thomotron/keyboard/TestKeypad/TestKeypad.kicad_pcb

## KiCad design TestKeypad/TestKeypad.kicad_pcb (2021-01-30)

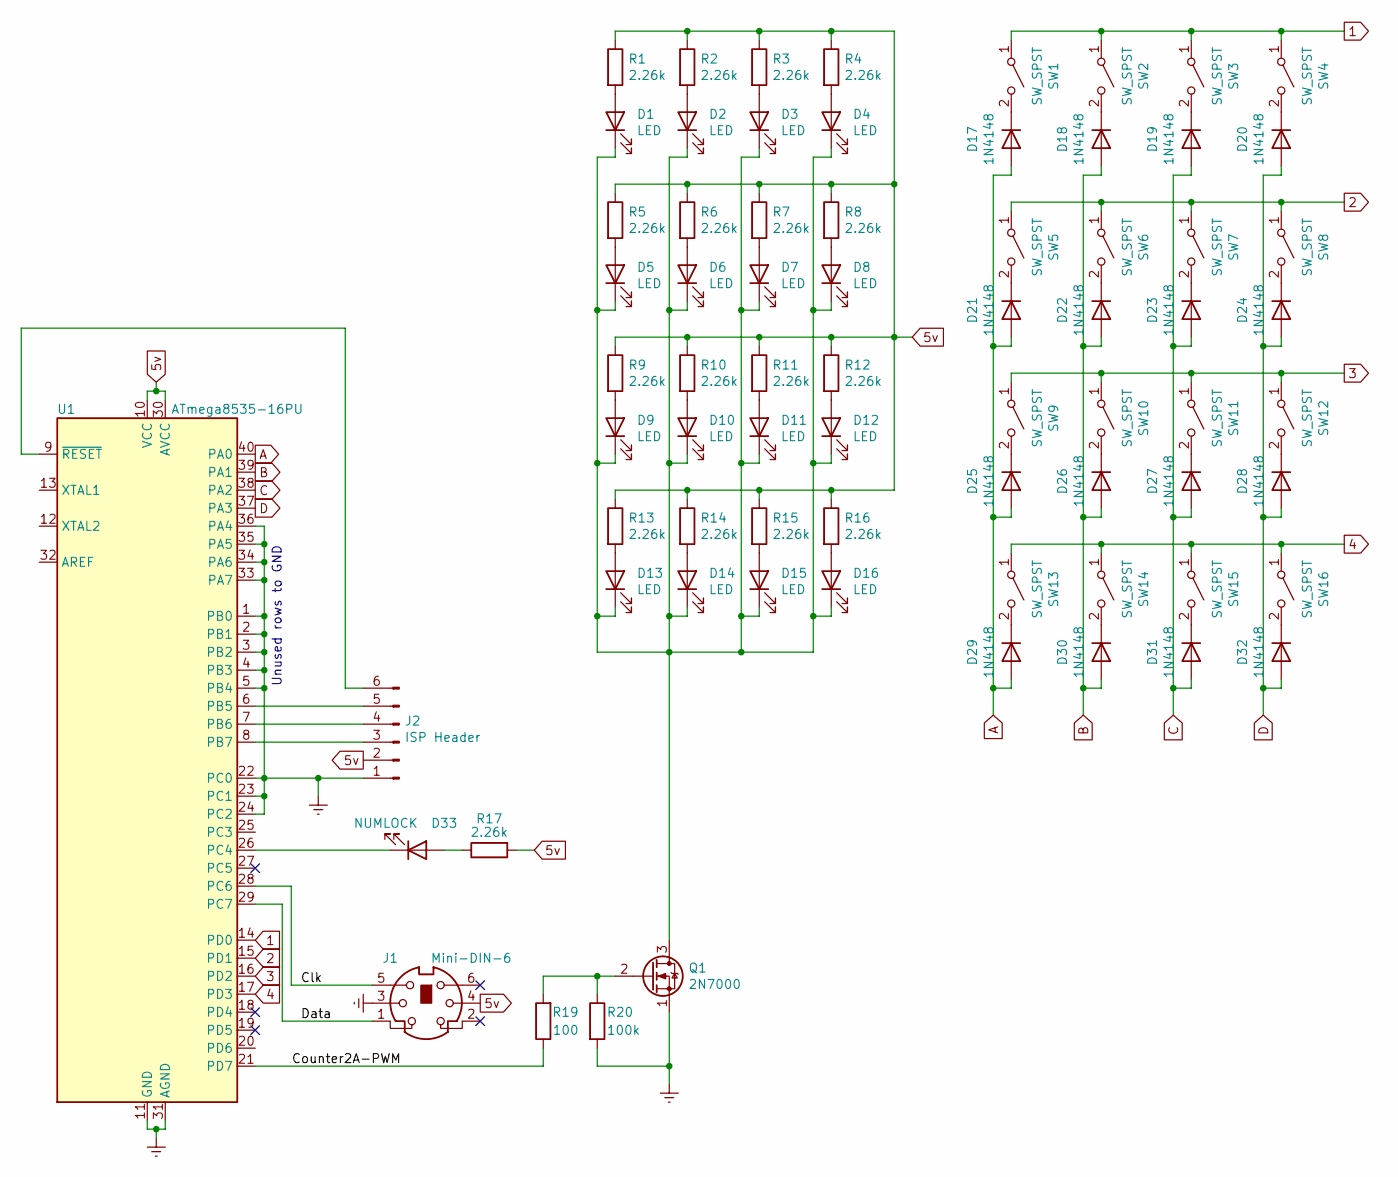
[picture p1: schematic TestKeypad.sch]

Parts:
D1, D2, D3, D4, D5, D6, D7, D8, D9, D10, D11, D12, D13, D14, D15, D16: LED; 158301250
D17, D18, D19, D20, D21, D22, D23, D24, D25, D26, D27, D28, D29, D30, D31, D32: 1N4148; D_MiniMELF
D33: NUMLOCK; 158301250
J1: Mini-DIN-6; Connector_Mini-DIN_Female_6Pin_2rows
J2: ISP Header; PinHeader_2x03_P2.54mm_Vertical
Q1: 2N7000; TO-92_Inline
R1, R2, R3, R4, R5, R6, R7, R8, R9, R10, R11, R12, R13, R14, R15, R16, R17: 2.26k; R_0805_2012Metric_Pad1.15x1.40mm_HandSolder
R19: 100; R_0805_2012Metric_Pad1.15x1.40mm_HandSolder
R20: 100k; R_0805_2012Metric_Pad1.15x1.40mm_HandSolder
SW1, SW2, SW3, SW4, SW5, SW6, SW7, SW8, SW9, SW10, SW11, SW12, SW13, SW14, SW15, SW16: SW_SPST; SW_Cherry_MX_1.00u_PCB
U1: ATmega8535-16PU; DIP-40_W15.24mm_Socket

Connections:
1: SW1.1 (A), SW2.1 (A), SW3.1 (A), SW4.1 (A), U1.14 (PD0)
2: SW5.1 (A), SW6.1 (A), SW7.1 (A), SW8.1 (A), U1.15 (PD1)
3: SW9.1 (A), SW10.1 (A), SW11.1 (A), SW12.1 (A), U1.16 (PD2)
4: SW13.1 (A), SW14.1 (A), SW15.1 (A), SW16.1 (A), U1.17 (PD3)
5v: J1.4, J2.2, R1.1, R2.1, R3.1, R4.1, R5.1, R6.1, R7.1, R8.1, R9.1, R10.1, R11.1, R12.1, R13.1, R14.1, R15.1, R16.1, R17.2, U1.10 (VCC), U1.30 (AVCC)
/Clk: J1.5, U1.28 (PC6)
/Counter2A-PWM: R19.1, U1.21 (PD7)
/Data: J1.1, U1.29 (PC7)
A: D17.2 (A), D21.2 (A), D25.2 (A), D29.2 (A), U1.40 (PA0)
B: D18.2 (A), D22.2 (A), D26.2 (A), D30.2 (A), U1.39 (PA1)
C: D19.2 (A), D23.2 (A), D27.2 (A), D31.2 (A), U1.38 (PA2)
D: D20.2 (A), D24.2 (A), D28.2 (A), D32.2 (A), U1.37 (PA3)
Earth: J1.3, J2.1, Q1.1 (S), R20.2, U1.1 (PB0), U1.2 (PB1), U1.3 (PB2), U1.4 (PB3), U1.5 (PB4), U1.11 (GND), U1.22 (PC0), U1.23 (PC1), U1.24 (PC2), U1.31 (AGND), U1.33 (PA7), U1.34 (PA6), U1.35 (PA5), U1.36 (PA4)
unnamed: D1.1 (K), D2.1 (K), D3.1 (K), D4.1 (K), D5.1 (K), D6.1 (K), D7.1 (K), D8.1 (K), D9.1 (K), D10.1 (K), D11.1 (K), D12.1 (K), D13.1 (K), D14.1 (K), D15.1 (K), D16.1 (K), Q1.3 (D)
unnamed: D1.2 (A), R1.2
unnamed: D2.2 (A), R2.2
unnamed: D3.2 (A), R3.2
unnamed: D4.2 (A), R4.2
unnamed: D5.2 (A), R5.2
unnamed: D6.2 (A), R6.2
unnamed: D7.2 (A), R7.2
unnamed: D8.2 (A), R8.2
unnamed: D9.2 (A), R9.2
unnamed: D10.2 (A), R10.2
unnamed: D11.2 (A), R11.2
unnamed: D12.2 (A), R12.2
unnamed: D13.2 (A), R13.2
unnamed: D14.2 (A), R14.2
unnamed: D15.2 (A), R15.2
unnamed: D16.2 (A), R16.2
unnamed: D17.1 (K), SW1.2 (B)
unnamed: D18.1 (K), SW2.2 (B)
unnamed: D19.1 (K), SW3.2 (B)
unnamed: D20.1 (K), SW4.2 (B)
unnamed: D21.1 (K), SW5.2 (B)
unnamed: D22.1 (K), SW6.2 (B)
unnamed: D23.1 (K), SW7.2 (B)
unnamed: D24.1 (K), SW8.2 (B)
unnamed: D25.1 (K), SW9.2 (B)
unnamed: D26.1 (K), SW10.2 (B)
unnamed: D27.1 (K), SW11.2 (B)
unnamed: D28.1 (K), SW12.2 (B)
unnamed: D29.1 (K), SW13.2 (B)
unnamed: D30.1 (K), SW14.2 (B)
unnamed: D31.1 (K), SW15.2 (B)
unnamed: D32.1 (K), SW16.2 (B)
unnamed: D33.1 (K), U1.26 (PC4)
unnamed: D33.2 (A), R17.1
unnamed: J2.3, U1.8 (PB7)
unnamed: J2.4, U1.7 (PB6)
unnamed: J2.5, U1.6 (PB5)
unnamed: J2.6, U1.9 (~RESET)
unnamed: Q1.2 (G), R19.2, R20.1

Notes on the sheet:
Unused rows to GND

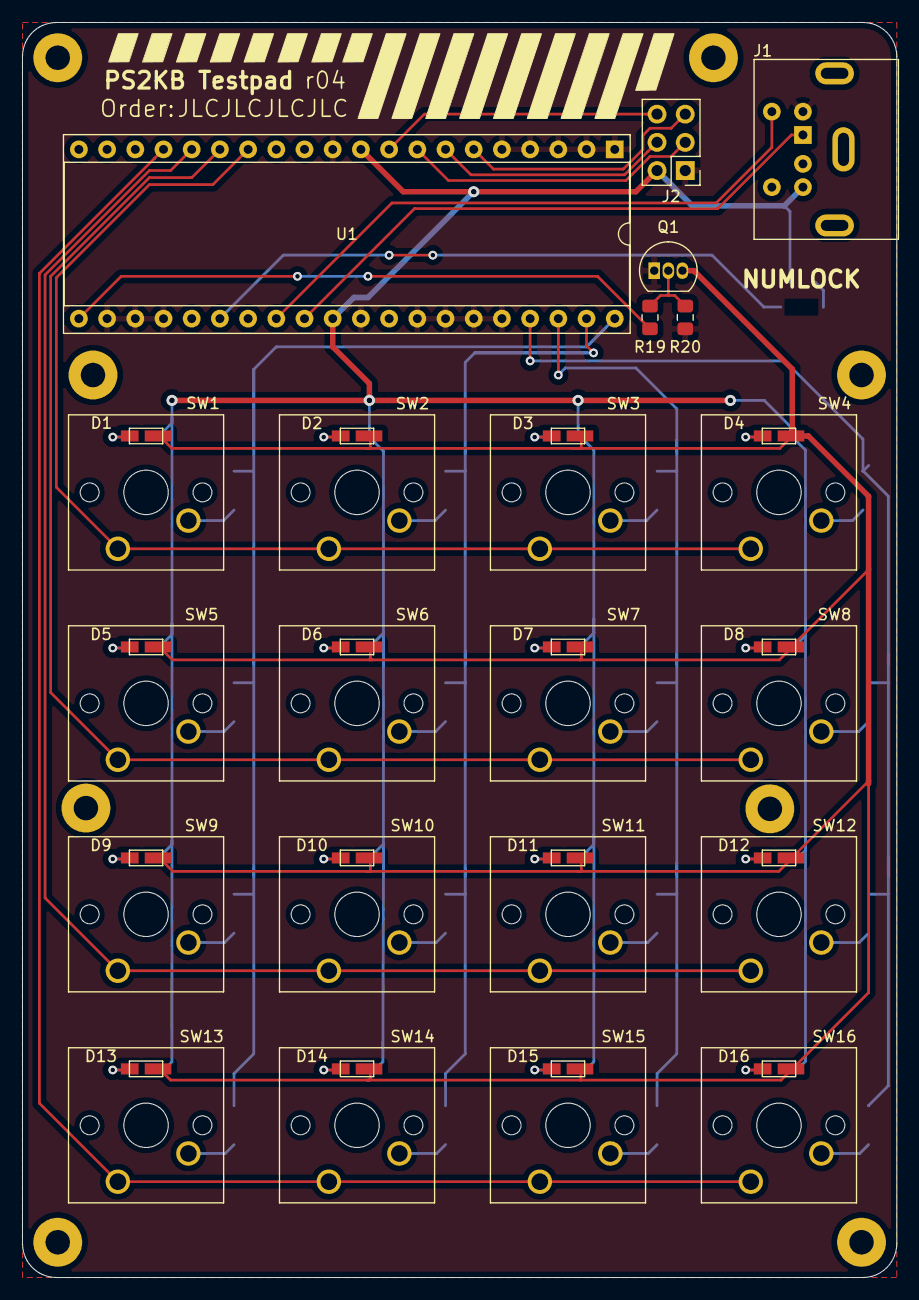
[picture p2: board TestKeypad.kicad_pcb from above]

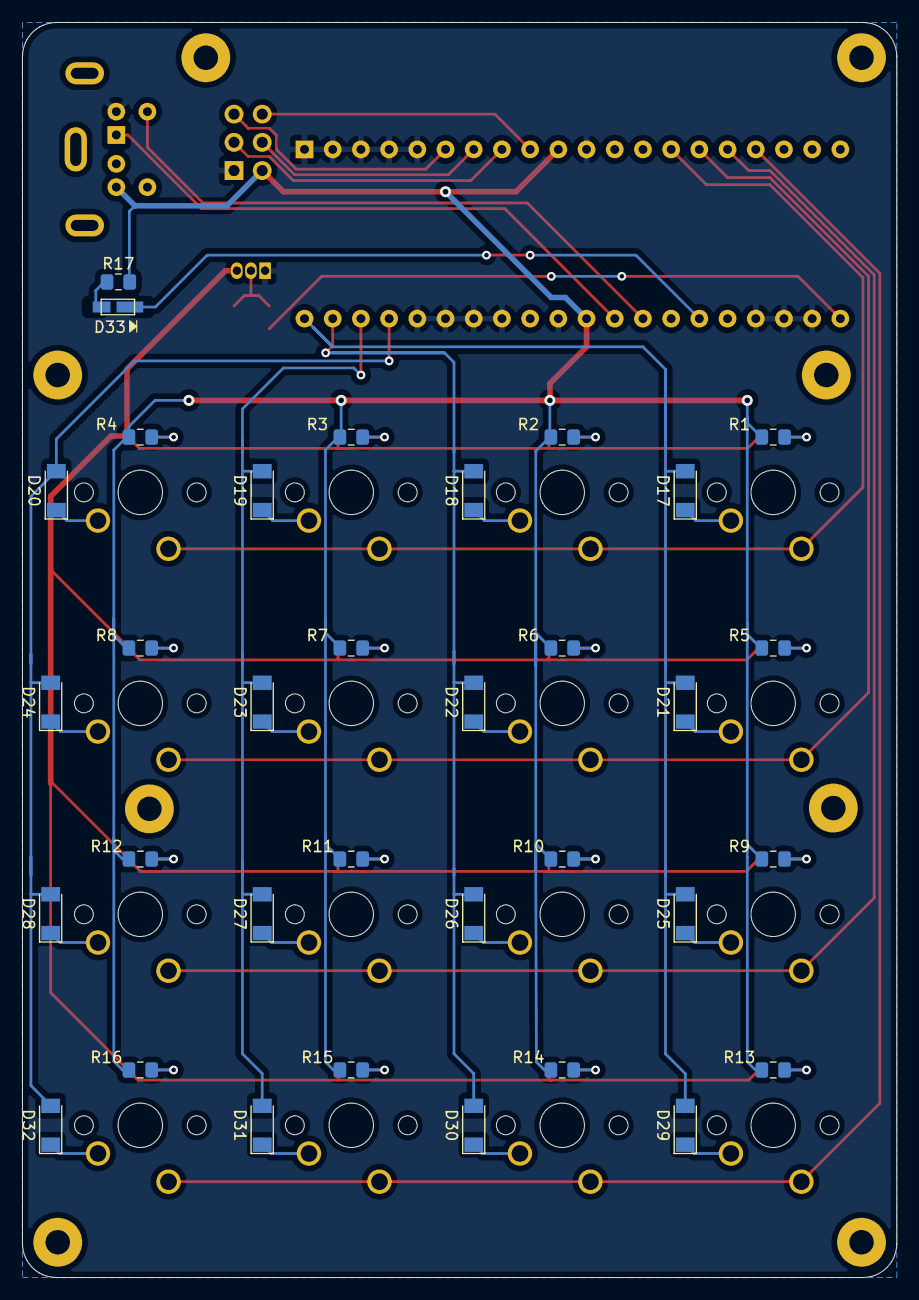
[picture p3: board TestKeypad.kicad_pcb from below]

Board: 2 copper layers, 78.7 x 113.0 mm, 72 parts (34 on the bottom side), 53 nets.
