thomotron/keyboard/Keyboard/MyOwnKeyboard.kicad_pcb

## KiCad design Keyboard/MyOwnKeyboard.kicad_pcb (2020-12-05)

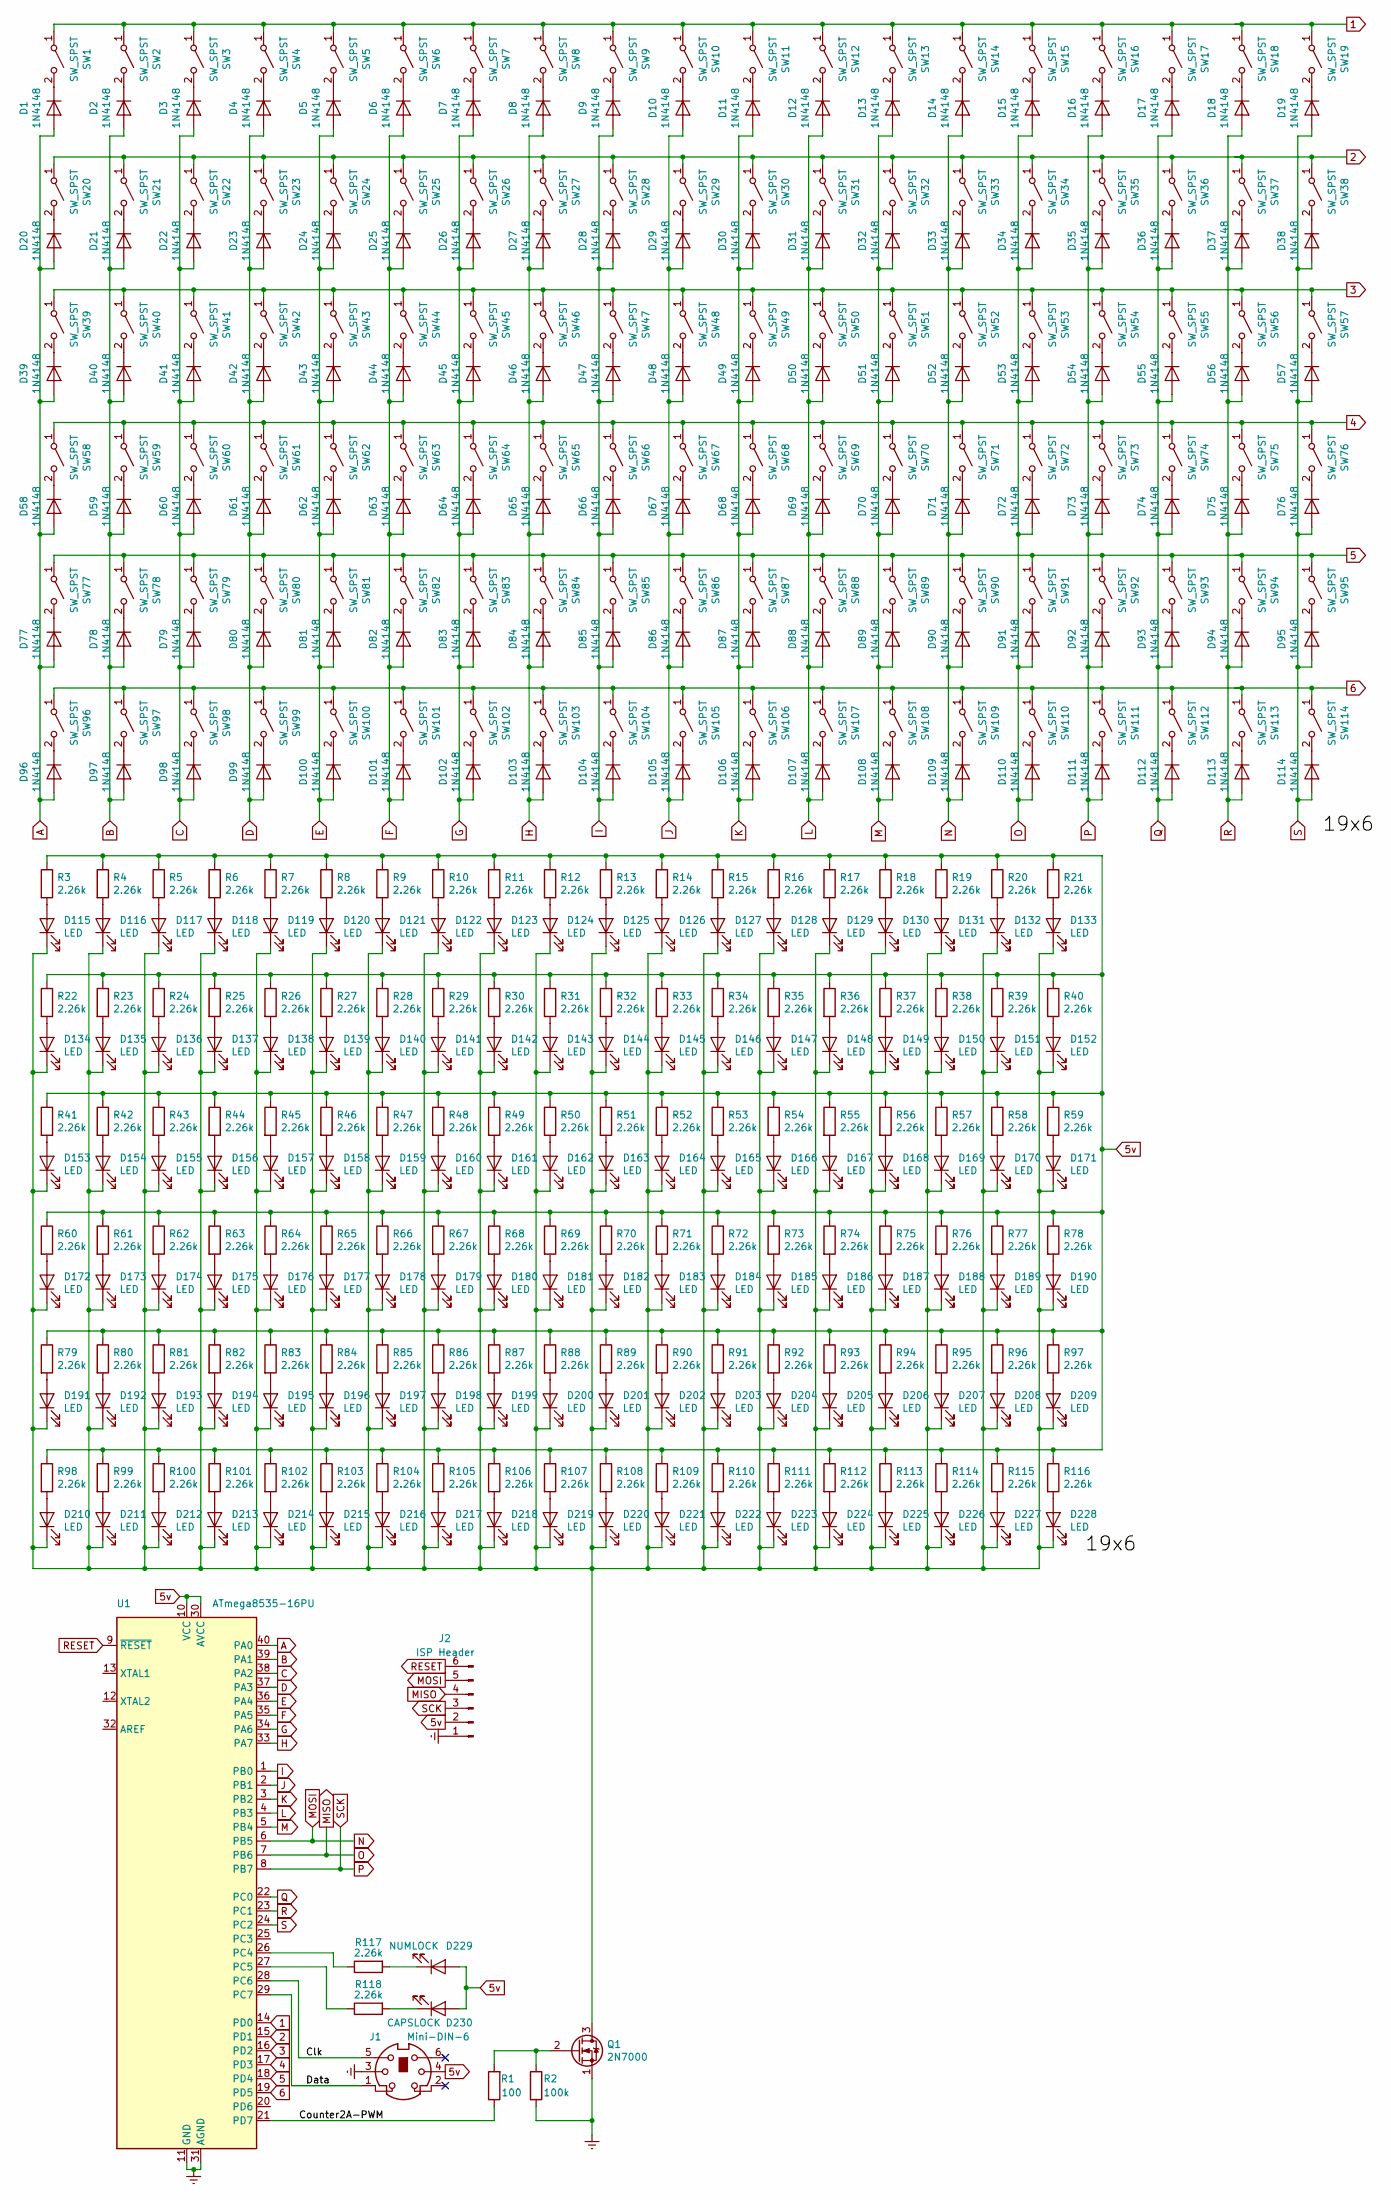
[picture p4: schematic MyOwnKeyboard.sch]

Parts:
D1, D2, D3, D4, D5, D6, D7, D8, D9, D10, D11, D12, D13, D14, D15, D16, D17, D18, D19, D20, D21, D22, D23, D24, D25, D26, D27, D28, D29, D30, D31, D32, D33, D34, D35, D36, D37, D38, D39, D40, D41, D42, D43, D44, D45, D46, D47, D48, D49, D50, D51, D52, D53, D54, D55, D56, D57, D58, D59, D60, D61, D62, D63, D64, D65, D66, D67, D68, D69, D70, D71, D72, D73, D74, D75, D76, D77, D78, D79, D80, D81, D82, D83, D84, D85, D86, D87, D88, D89, D90, D91, D92, D93, D94, D95, D96, D97, D98, D99, D100, D101, D102, D103, D104, D105, D106, D107, D108, D109, D110, D111, D112, D113, D114: 1N4148; D_MiniMELF
D115, D116, D117, D118, D119, D120, D121, D122, D123, D124, D125, D126, D127, D128, D129, D130, D131, D132, D133, D134, D135, D136, D137, D138, D139, D140, D141, D142, D143, D144, D145, D146, D147, D148, D149, D150, D151, D152, D153, D154, D155, D156, D157, D158, D159, D160, D161, D162, D163, D164, D165, D166, D167, D168, D169, D170, D171, D172, D173, D174, D175, D176, D177, D178, D179, D180, D181, D182, D183, D184, D185, D186, D187, D188, D189, D190, D191, D192, D193, D194, D195, D196, D197, D198, D199, D200, D201, D202, D203, D204, D205, D206, D207, D208, D209, D210, D211, D212, D213, D214, D215, D216, D217, D218, D219, D220, D221, D222, D223, D224, D225, D226, D227, D228: LED; 158301250
D229: NUMLOCK; 158301250
D230: CAPSLOCK; 158301250
J1: Mini-DIN-6; Connector_Mini-DIN_Female_6Pin_2rows
J2: ISP Header; PinHeader_2x03_P2.54mm_Vertical
Q1: 2N7000; TO-92_Inline
R1: 100; R_0805_2012Metric_Pad1.15x1.40mm_HandSolder
R2: 100k; R_0805_2012Metric_Pad1.15x1.40mm_HandSolder
R3, R4, R5, R6, R7, R8, R9, R10, R11, R12, R13, R14, R15, R16, R17, R18, R19, R20, R21, R22, R23, R24, R25, R26, R27, R28, R29, R30, R31, R32, R33, R34, R35, R36, R37, R38, R39, R40, R41, R42, R43, R44, R45, R46, R47, R48, R49, R50, R51, R52, R53, R54, R55, R56, R57, R58, R59, R60, R61, R62, R63, R64, R65, R66, R67, R68, R69, R70, R71, R72, R73, R74, R75, R76, R77, R78, R79, R80, R81, R82, R83, R84, R85, R86, R87, R88, R89, R90, R91, R92, R93, R94, R95, R96, R97, R98, R99, R100, R101, R102, R103, R104, R105, R106, R107, R108, R109, R110, R111, R112, R113, R114, R115, R116, R117, R118: 2.26k; R_0805_2012Metric_Pad1.15x1.40mm_HandSolder
SW1, SW2, SW3, SW4, SW5, SW6, SW7, SW8, SW9, SW10, SW11, SW12, SW13, SW14, SW15, SW16, SW17, SW18, SW19, SW20, SW21, SW22, SW23, SW24, SW25, SW26, SW27, SW28, SW29, SW30, SW31, SW32, SW33, SW34, SW35, SW36, SW37, SW38, SW39, SW40, SW41, SW42, SW43, SW44, SW45, SW46, SW47, SW48, SW49, SW50, SW51, SW52, SW53, SW54, SW55, SW56, SW57, SW58, SW59, SW60, SW61, SW62, SW63, SW64, SW65, SW66, SW67, SW68, SW69, SW70, SW71, SW72, SW73, SW74, SW75, SW76, SW77, SW78, SW79, SW80, SW81, SW82, SW83, SW84, SW85, SW86, SW87, SW88, SW89, SW90, SW91, SW92, SW93, SW94, SW95, SW96, SW97, SW98, SW99, SW100, SW101, SW102, SW103, SW104, SW105, SW106, SW107, SW108, SW109, SW110, SW111, SW112, SW113, SW114: SW_SPST; SW_Cherry_MX_1.00u_PCB
U1: ATmega8535-16PU; DIP-40_W15.24mm

Connections:
1: SW1.1 (A), SW2.1 (A), SW3.1 (A), SW4.1 (A), SW5.1 (A), SW6.1 (A), SW7.1 (A), SW8.1 (A), SW9.1 (A), SW10.1 (A), SW11.1 (A), SW12.1 (A), SW13.1 (A), SW14.1 (A), SW15.1 (A), SW16.1 (A), SW17.1 (A), SW18.1 (A), SW19.1 (A), U1.14 (PD0)
2: SW20.1 (A), SW21.1 (A), SW22.1 (A), SW23.1 (A), SW24.1 (A), SW25.1 (A), SW26.1 (A), SW27.1 (A), SW28.1 (A), SW29.1 (A), SW30.1 (A), SW31.1 (A), SW32.1 (A), SW33.1 (A), SW34.1 (A), SW35.1 (A), SW36.1 (A), SW37.1 (A), SW38.1 (A), U1.15 (PD1)
3: SW39.1 (A), SW40.1 (A), SW41.1 (A), SW42.1 (A), SW43.1 (A), SW44.1 (A), SW45.1 (A), SW46.1 (A), SW47.1 (A), SW48.1 (A), SW49.1 (A), SW50.1 (A), SW51.1 (A), SW52.1 (A), SW53.1 (A), SW54.1 (A), SW55.1 (A), SW56.1 (A), SW57.1 (A), U1.16 (PD2)
4: SW58.1 (A), SW59.1 (A), SW60.1 (A), SW61.1 (A), SW62.1 (A), SW63.1 (A), SW64.1 (A), SW65.1 (A), SW66.1 (A), SW67.1 (A), SW68.1 (A), SW69.1 (A), SW70.1 (A), SW71.1 (A), SW72.1 (A), SW73.1 (A), SW74.1 (A), SW75.1 (A), SW76.1 (A), U1.17 (PD3)
5: SW77.1 (A), SW78.1 (A), SW79.1 (A), SW80.1 (A), SW81.1 (A), SW82.1 (A), SW83.1 (A), SW84.1 (A), SW85.1 (A), SW86.1 (A), SW87.1 (A), SW88.1 (A), SW89.1 (A), SW90.1 (A), SW91.1 (A), SW92.1 (A), SW93.1 (A), SW94.1 (A), SW95.1 (A), U1.18 (PD4)
5v: D229.2 (A), D230.2 (A), J1.4, J2.2, R3.1, R4.1, R5.1, R6.1, R7.1, R8.1, R9.1, R10.1, R11.1, R12.1, R13.1, R14.1, R15.1, R16.1, R17.1, R18.1, R19.1, R20.1, R21.1, R22.1, R23.1, R24.1, R25.1, R26.1, R27.1, R28.1, R29.1, R30.1, R31.1, R32.1, R33.1, R34.1, R35.1, R36.1, R37.1, R38.1, R39.1, R40.1, R41.1, R42.1, R43.1, R44.1, R45.1, R46.1, R47.1, R48.1, R49.1, R50.1, R51.1, R52.1, R53.1, R54.1, R55.1, R56.1, R57.1, R58.1, R59.1, R60.1, R61.1, R62.1, R63.1, R64.1, R65.1, R66.1, R67.1, R68.1, R69.1, R70.1, R71.1, R72.1, R73.1, R74.1, R75.1, R76.1, R77.1, R78.1, R79.1, R80.1, R81.1, R82.1, R83.1, R84.1, R85.1, R86.1, R87.1, R88.1, R89.1, R90.1, R91.1, R92.1, R93.1, R94.1, R95.1, R96.1, R97.1, R98.1, R99.1, R100.1, R101.1, R102.1, R103.1, R104.1, R105.1, R106.1, R107.1, R108.1, R109.1, R110.1, R111.1, R112.1, R113.1, R114.1, R115.1, R116.1, U1.10 (VCC), U1.30 (AVCC)
6: SW96.1 (A), SW97.1 (A), SW98.1 (A), SW99.1 (A), SW100.1 (A), SW101.1 (A), SW102.1 (A), SW103.1 (A), SW104.1 (A), SW105.1 (A), SW106.1 (A), SW107.1 (A), SW108.1 (A), SW109.1 (A), SW110.1 (A), SW111.1 (A), SW112.1 (A), SW113.1 (A), SW114.1 (A), U1.19 (PD5)
/Clk: J1.5, U1.28 (PC6)
/Counter2A-PWM: R1.1, U1.21 (PD7)
/Data: J1.1, U1.29 (PC7)
A: D1.2 (A), D20.2 (A), D39.2 (A), D58.2 (A), D77.2 (A), D96.2 (A), U1.40 (PA0)
B: D2.2 (A), D21.2 (A), D40.2 (A), D59.2 (A), D78.2 (A), D97.2 (A), U1.39 (PA1)
C: D3.2 (A), D22.2 (A), D41.2 (A), D60.2 (A), D79.2 (A), D98.2 (A), U1.38 (PA2)
D: D4.2 (A), D23.2 (A), D42.2 (A), D61.2 (A), D80.2 (A), D99.2 (A), U1.37 (PA3)
E: D5.2 (A), D24.2 (A), D43.2 (A), D62.2 (A), D81.2 (A), D100.2 (A), U1.36 (PA4)
Earth: J1.3, J2.1, Q1.1 (S), R2.2, U1.11 (GND), U1.31 (AGND)
F: D6.2 (A), D25.2 (A), D44.2 (A), D63.2 (A), D82.2 (A), D101.2 (A), U1.35 (PA5)
G: D7.2 (A), D26.2 (A), D45.2 (A), D64.2 (A), D83.2 (A), D102.2 (A), U1.34 (PA6)
H: D8.2 (A), D27.2 (A), D46.2 (A), D65.2 (A), D84.2 (A), D103.2 (A), U1.33 (PA7)
I: D9.2 (A), D28.2 (A), D47.2 (A), D66.2 (A), D85.2 (A), D104.2 (A), U1.1 (PB0)
J: D10.2 (A), D29.2 (A), D48.2 (A), D67.2 (A), D86.2 (A), D105.2 (A), U1.2 (PB1)
K: D11.2 (A), D30.2 (A), D49.2 (A), D68.2 (A), D87.2 (A), D106.2 (A), U1.3 (PB2)
L: D12.2 (A), D31.2 (A), D50.2 (A), D69.2 (A), D88.2 (A), D107.2 (A), U1.4 (PB3)
M: D13.2 (A), D32.2 (A), D51.2 (A), D70.2 (A), D89.2 (A), D108.2 (A), U1.5 (PB4)
MISO: D15.2 (A), D34.2 (A), D53.2 (A), D72.2 (A), D91.2 (A), D110.2 (A), J2.4, U1.7 (PB6)
MOSI: D14.2 (A), D33.2 (A), D52.2 (A), D71.2 (A), D90.2 (A), D109.2 (A), J2.5, U1.6 (PB5)
unnamed: D1.1 (K), SW1.2 (B)
unnamed: D2.1 (K), SW2.2 (B)
unnamed: D3.1 (K), SW3.2 (B)
unnamed: D4.1 (K), SW4.2 (B)
unnamed: D5.1 (K), SW5.2 (B)
unnamed: D6.1 (K), SW6.2 (B)
unnamed: D7.1 (K), SW7.2 (B)
unnamed: D8.1 (K), SW8.2 (B)
unnamed: D9.1 (K), SW9.2 (B)
unnamed: D10.1 (K), SW10.2 (B)
unnamed: D11.1 (K), SW11.2 (B)
unnamed: D12.1 (K), SW12.2 (B)
unnamed: D13.1 (K), SW13.2 (B)
unnamed: D14.1 (K), SW14.2 (B)
unnamed: D15.1 (K), SW15.2 (B)
unnamed: D16.1 (K), SW16.2 (B)
unnamed: D17.1 (K), SW17.2 (B)
unnamed: D18.1 (K), SW18.2 (B)
unnamed: D19.1 (K), SW19.2 (B)
unnamed: D20.1 (K), SW20.2 (B)
unnamed: D21.1 (K), SW21.2 (B)
unnamed: D22.1 (K), SW22.2 (B)
unnamed: D23.1 (K), SW23.2 (B)
unnamed: D24.1 (K), SW24.2 (B)
unnamed: D25.1 (K), SW25.2 (B)
unnamed: D26.1 (K), SW26.2 (B)
unnamed: D27.1 (K), SW27.2 (B)
unnamed: D28.1 (K), SW28.2 (B)
unnamed: D29.1 (K), SW29.2 (B)
unnamed: D30.1 (K), SW30.2 (B)
unnamed: D31.1 (K), SW31.2 (B)
unnamed: D32.1 (K), SW32.2 (B)
unnamed: D33.1 (K), SW33.2 (B)
unnamed: D34.1 (K), SW34.2 (B)
unnamed: D35.1 (K), SW35.2 (B)
unnamed: D36.1 (K), SW36.2 (B)
unnamed: D37.1 (K), SW37.2 (B)
unnamed: D38.1 (K), SW38.2 (B)
unnamed: D39.1 (K), SW39.2 (B)
unnamed: D40.1 (K), SW40.2 (B)
unnamed: D41.1 (K), SW41.2 (B)
unnamed: D42.1 (K), SW42.2 (B)
unnamed: D43.1 (K), SW43.2 (B)
unnamed: D44.1 (K), SW44.2 (B)
unnamed: D45.1 (K), SW45.2 (B)
unnamed: D46.1 (K), SW46.2 (B)
unnamed: D47.1 (K), SW47.2 (B)
unnamed: D48.1 (K), SW48.2 (B)
unnamed: D49.1 (K), SW49.2 (B)
unnamed: D50.1 (K), SW50.2 (B)
unnamed: D51.1 (K), SW51.2 (B)
unnamed: D52.1 (K), SW52.2 (B)
unnamed: D53.1 (K), SW53.2 (B)
unnamed: D54.1 (K), SW54.2 (B)
unnamed: D55.1 (K), SW55.2 (B)
unnamed: D56.1 (K), SW56.2 (B)
unnamed: D57.1 (K), SW57.2 (B)
unnamed: D58.1 (K), SW58.2 (B)
unnamed: D59.1 (K), SW59.2 (B)
unnamed: D60.1 (K), SW60.2 (B)
unnamed: D61.1 (K), SW61.2 (B)
unnamed: D62.1 (K), SW62.2 (B)
unnamed: D63.1 (K), SW63.2 (B)
unnamed: D64.1 (K), SW64.2 (B)
unnamed: D65.1 (K), SW65.2 (B)
unnamed: D66.1 (K), SW66.2 (B)
unnamed: D67.1 (K), SW67.2 (B)
unnamed: D68.1 (K), SW68.2 (B)
unnamed: D69.1 (K), SW69.2 (B)
unnamed: D70.1 (K), SW70.2 (B)
unnamed: D71.1 (K), SW71.2 (B)
unnamed: D72.1 (K), SW72.2 (B)
unnamed: D73.1 (K), SW73.2 (B)
unnamed: D74.1 (K), SW74.2 (B)
unnamed: D75.1 (K), SW75.2 (B)
unnamed: D76.1 (K), SW76.2 (B)
unnamed: D77.1 (K), SW77.2 (B)
unnamed: D78.1 (K), SW78.2 (B)
unnamed: D79.1 (K), SW79.2 (B)
unnamed: D80.1 (K), SW80.2 (B)
unnamed: D81.1 (K), SW81.2 (B)
unnamed: D82.1 (K), SW82.2 (B)
unnamed: D83.1 (K), SW83.2 (B)
unnamed: D84.1 (K), SW84.2 (B)
unnamed: D85.1 (K), SW85.2 (B)
unnamed: D86.1 (K), SW86.2 (B)
unnamed: D87.1 (K), SW87.2 (B)
unnamed: D88.1 (K), SW88.2 (B)
unnamed: D89.1 (K), SW89.2 (B)
unnamed: D90.1 (K), SW90.2 (B)
unnamed: D91.1 (K), SW91.2 (B)
unnamed: D92.1 (K), SW92.2 (B)
unnamed: D93.1 (K), SW93.2 (B)
unnamed: D94.1 (K), SW94.2 (B)
unnamed: D95.1 (K), SW95.2 (B)
unnamed: D96.1 (K), SW96.2 (B)
unnamed: D97.1 (K), SW97.2 (B)
unnamed: D98.1 (K), SW98.2 (B)
unnamed: D99.1 (K), SW99.2 (B)
unnamed: D100.1 (K), SW100.2 (B)
unnamed: D101.1 (K), SW101.2 (B)
unnamed: D102.1 (K), SW102.2 (B)
unnamed: D103.1 (K), SW103.2 (B)
unnamed: D104.1 (K), SW104.2 (B)
unnamed: D105.1 (K), SW105.2 (B)
unnamed: D106.1 (K), SW106.2 (B)
unnamed: D107.1 (K), SW107.2 (B)
unnamed: D108.1 (K), SW108.2 (B)
unnamed: D109.1 (K), SW109.2 (B)
unnamed: D110.1 (K), SW110.2 (B)
unnamed: D111.1 (K), SW111.2 (B)
unnamed: D112.1 (K), SW112.2 (B)
unnamed: D113.1 (K), SW113.2 (B)
unnamed: D114.1 (K), SW114.2 (B)
unnamed: D115.1 (K), D116.1 (K), D117.1 (K), D118.1 (K), D119.1 (K), D120.1 (K), D121.1 (K), D122.1 (K), D123.1 (K), D124.1 (K), D125.1 (K), D126.1 (K), D127.1 (K), D128.1 (K), D129.1 (K), D130.1 (K), D131.1 (K), D132.1 (K), D133.1 (K), D134.1 (K), D135.1 (K), D136.1 (K), D137.1 (K), D138.1 (K), D139.1 (K), D140.1 (K), D141.1 (K), D142.1 (K), D143.1 (K), D144.1 (K), D145.1 (K), D146.1 (K), D147.1 (K), D148.1 (K), D149.1 (K), D150.1 (K), D151.1 (K), D152.1 (K), D153.1 (K), D154.1 (K), D155.1 (K), D156.1 (K), D157.1 (K), D158.1 (K), D159.1 (K), D160.1 (K), D161.1 (K), D162.1 (K), D163.1 (K), D164.1 (K), D165.1 (K), D166.1 (K), D167.1 (K), D168.1 (K), D169.1 (K), D170.1 (K), D171.1 (K), D172.1 (K), D173.1 (K), D174.1 (K), D175.1 (K), D176.1 (K), D177.1 (K), D178.1 (K), D179.1 (K), D180.1 (K), D181.1 (K), D182.1 (K), D183.1 (K), D184.1 (K), D185.1 (K), D186.1 (K), D187.1 (K), D188.1 (K), D189.1 (K), D190.1 (K), D191.1 (K), D192.1 (K), D193.1 (K), D194.1 (K), D195.1 (K), D196.1 (K), D197.1 (K), D198.1 (K), D199.1 (K), D200.1 (K), D201.1 (K), D202.1 (K), D203.1 (K), D204.1 (K), D205.1 (K), D206.1 (K), D207.1 (K), D208.1 (K), D209.1 (K), D210.1 (K), D211.1 (K), D212.1 (K), D213.1 (K), D214.1 (K), D215.1 (K), D216.1 (K), D217.1 (K), D218.1 (K), D219.1 (K), D220.1 (K), D221.1 (K), D222.1 (K), D223.1 (K), D224.1 (K), D225.1 (K), D226.1 (K), D227.1 (K), D228.1 (K), Q1.3 (D)
unnamed: D115.2 (A), R3.2
unnamed: D116.2 (A), R4.2
unnamed: D117.2 (A), R5.2
unnamed: D118.2 (A), R6.2
unnamed: D119.2 (A), R7.2
unnamed: D120.2 (A), R8.2
unnamed: D121.2 (A), R9.2
unnamed: D122.2 (A), R10.2
unnamed: D123.2 (A), R11.2
unnamed: D124.2 (A), R12.2
unnamed: D125.2 (A), R13.2
unnamed: D126.2 (A), R14.2
unnamed: D127.2 (A), R15.2
unnamed: D128.2 (A), R16.2
unnamed: D129.2 (A), R17.2
unnamed: D130.2 (A), R18.2
unnamed: D131.2 (A), R19.2
unnamed: D132.2 (A), R20.2
unnamed: D133.2 (A), R21.2
unnamed: D134.2 (A), R22.2
unnamed: D135.2 (A), R23.2
unnamed: D136.2 (A), R24.2
unnamed: D137.2 (A), R25.2
unnamed: D138.2 (A), R26.2
unnamed: D139.2 (A), R27.2
unnamed: D140.2 (A), R28.2
unnamed: D141.2 (A), R29.2
unnamed: D142.2 (A), R30.2
unnamed: D143.2 (A), R31.2
unnamed: D144.2 (A), R32.2
unnamed: D145.2 (A), R33.2
unnamed: D146.2 (A), R34.2
unnamed: D147.2 (A), R35.2
unnamed: D148.2 (A), R36.2
unnamed: D149.2 (A), R37.2
unnamed: D150.2 (A), R38.2
unnamed: D151.2 (A), R39.2
unnamed: D152.2 (A), R40.2
unnamed: D153.2 (A), R41.2
unnamed: D154.2 (A), R42.2
unnamed: D155.2 (A), R43.2
unnamed: D156.2 (A), R44.2
unnamed: D157.2 (A), R45.2
unnamed: D158.2 (A), R46.2
unnamed: D159.2 (A), R47.2
unnamed: D160.2 (A), R48.2
unnamed: D161.2 (A), R49.2
unnamed: D162.2 (A), R50.2
unnamed: D163.2 (A), R51.2
unnamed: D164.2 (A), R52.2
unnamed: D165.2 (A), R53.2
unnamed: D166.2 (A), R54.2
unnamed: D167.2 (A), R55.2
unnamed: D168.2 (A), R56.2
unnamed: D169.2 (A), R57.2
unnamed: D170.2 (A), R58.2
unnamed: D171.2 (A), R59.2
unnamed: D172.2 (A), R60.2
unnamed: D173.2 (A), R61.2
unnamed: D174.2 (A), R62.2
unnamed: D175.2 (A), R63.2
unnamed: D176.2 (A), R64.2
unnamed: D177.2 (A), R65.2
unnamed: D178.2 (A), R66.2
unnamed: D179.2 (A), R67.2
unnamed: D180.2 (A), R68.2
unnamed: D181.2 (A), R69.2
unnamed: D182.2 (A), R70.2
unnamed: D183.2 (A), R71.2
unnamed: D184.2 (A), R72.2
unnamed: D185.2 (A), R73.2
unnamed: D186.2 (A), R74.2
unnamed: D187.2 (A), R75.2
unnamed: D188.2 (A), R76.2
unnamed: D189.2 (A), R77.2
unnamed: D190.2 (A), R78.2
unnamed: D191.2 (A), R79.2
unnamed: D192.2 (A), R80.2
unnamed: D193.2 (A), R81.2
unnamed: D194.2 (A), R82.2
unnamed: D195.2 (A), R83.2
unnamed: D196.2 (A), R84.2
unnamed: D197.2 (A), R85.2
unnamed: D198.2 (A), R86.2
unnamed: D199.2 (A), R87.2
unnamed: D200.2 (A), R88.2
unnamed: D201.2 (A), R89.2
unnamed: D202.2 (A), R90.2
unnamed: D203.2 (A), R91.2
unnamed: D204.2 (A), R92.2
unnamed: D205.2 (A), R93.2
unnamed: D206.2 (A), R94.2
unnamed: D207.2 (A), R95.2
unnamed: D208.2 (A), R96.2
unnamed: D209.2 (A), R97.2
unnamed: D210.2 (A), R98.2
unnamed: D211.2 (A), R99.2
unnamed: D212.2 (A), R100.2
unnamed: D213.2 (A), R101.2
unnamed: D214.2 (A), R102.2
unnamed: D215.2 (A), R103.2
unnamed: D216.2 (A), R104.2
unnamed: D217.2 (A), R105.2
unnamed: D218.2 (A), R106.2
unnamed: D219.2 (A), R107.2
unnamed: D220.2 (A), R108.2
unnamed: D221.2 (A), R109.2
unnamed: D222.2 (A), R110.2
unnamed: D223.2 (A), R111.2
unnamed: D224.2 (A), R112.2
unnamed: D225.2 (A), R113.2
unnamed: D226.2 (A), R114.2
unnamed: D227.2 (A), R115.2
unnamed: D228.2 (A), R116.2
unnamed: D229.1 (K), R117.2
unnamed: D230.1 (K), R118.2
unnamed: Q1.2 (G), R1.2, R2.1
unnamed: R117.1, U1.26 (PC4)
unnamed: R118.1, U1.27 (PC5)
P: D16.2 (A), D35.2 (A), D54.2 (A), D73.2 (A), D92.2 (A), D111.2 (A), J2.3, U1.8 (PB7)
Q: D17.2 (A), D36.2 (A), D55.2 (A), D74.2 (A), D93.2 (A), D112.2 (A), U1.22 (PC0)
R: D18.2 (A), D37.2 (A), D56.2 (A), D75.2 (A), D94.2 (A), D113.2 (A), U1.23 (PC1)
RESET: J2.6, U1.9 (~RESET)
S: D19.2 (A), D38.2 (A), D57.2 (A), D76.2 (A), D95.2 (A), D114.2 (A), U1.24 (PC2)

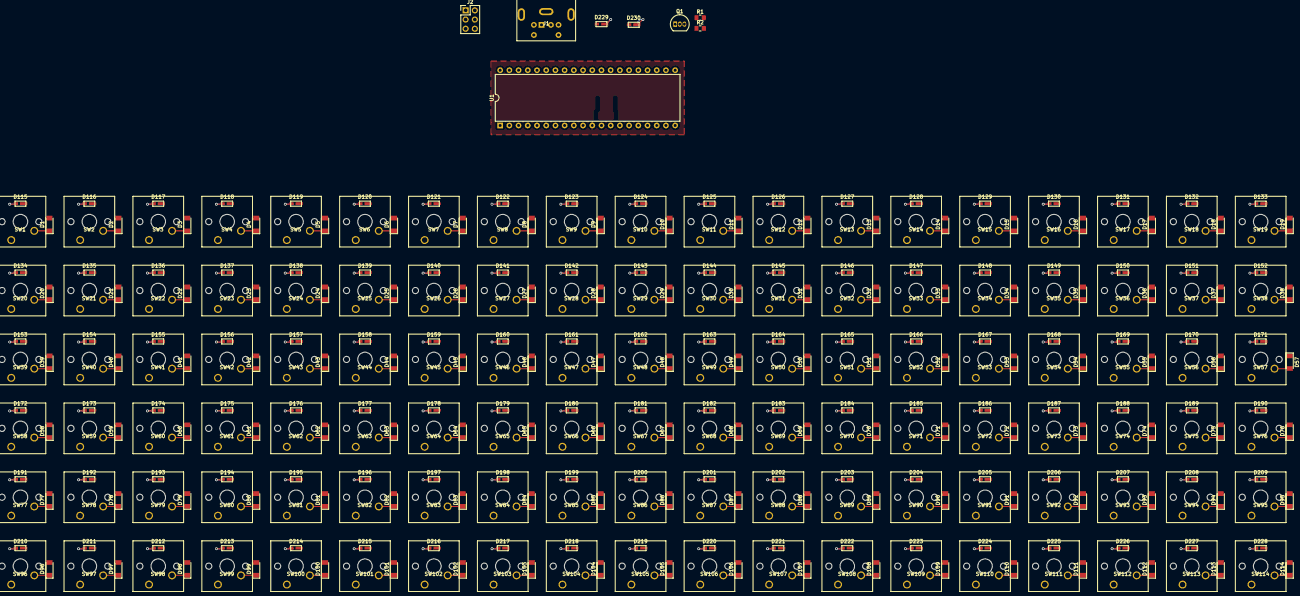
[picture p5: board MyOwnKeyboard.kicad_pcb from above]

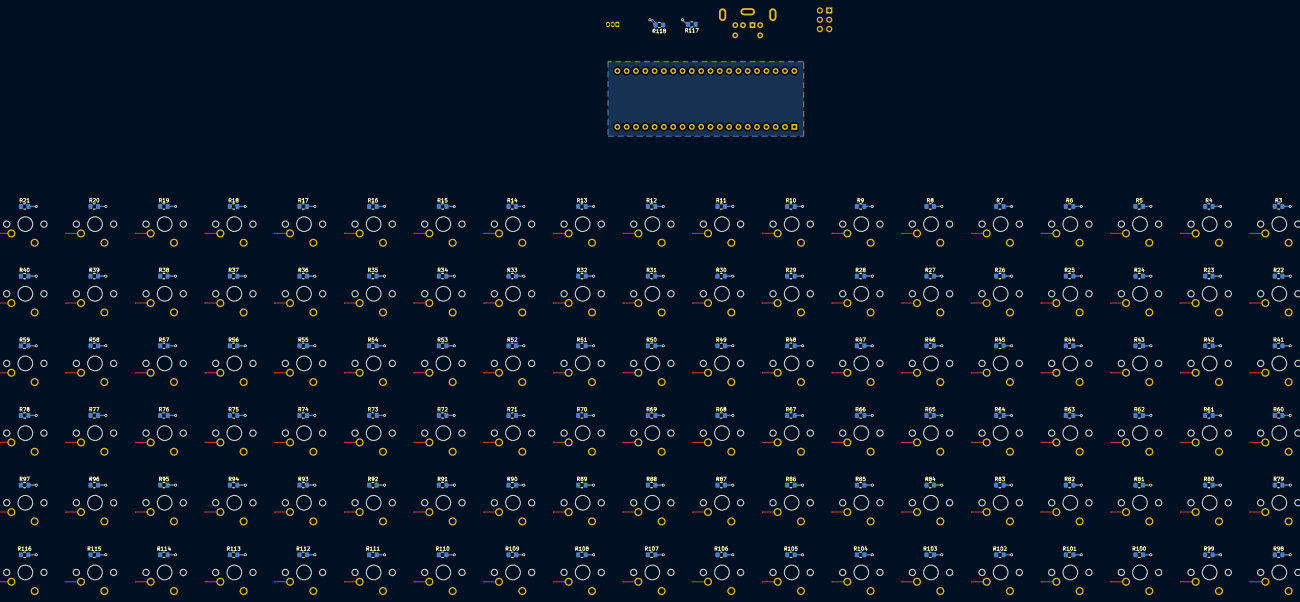
[picture p6: board MyOwnKeyboard.kicad_pcb from below]

Board: 2 copper layers, 466 parts (116 on the bottom side), 265 nets.
