thomotron/keyboard/(commit log)

2020-05-01 Initial commit 🎉
    [MyOwnKeyboard.kicad_pcb, MyOwnKeyboard.sch]
2020-05-01 Assigned switches Romer-G footprint
    [MyOwnKeyboard.sch]
2020-05-01 Migrate to the ATMega164
    Why use IO expanders when you can just get more pins. It still turns out ~$3 cheaper.
    [MyOwnKeyboard.sch]
2020-05-01 Add LED and assign footprints
    [MyOwnKeyboard.kicad_pcb, MyOwnKeyboard.sch]
2020-05-02 Add per-key LEDs, basic PCB layout
    [MyOwnKeyboard.kicad_pcb, MyOwnKeyboard.sch]
2020-05-03 Add NUM/CAPSLOCK indicators, finalise components
    [MyOwnKeyboard.kicad_pcb, MyOwnKeyboard.sch]
2020-05-03 Removed crystal, finalised design
    [MyOwnKeyboard.kicad_pcb, MyOwnKeyboard.sch]
2020-05-03 Update resistor values to squeeze out some of that sweet, sweet current
    [MyOwnKeyboard.sch]
2020-05-05 Extract libraries and move project down one level
    [MyOwnKeyboard.kicad_pcb, MyOwnKeyboard.sch]
2020-05-10 Add test keypad
    diff --git a/TestKeypad/TestKeypad-cache.lib b/TestKeypad/TestKeypad-cache.lib
    new file mode 100644
    index 0000000..1c2d1c4
    --- /dev/null
    +++ b/TestKeypad/TestKeypad-cache.lib
    @@ -0,0 +1,198 @@
    +EESchema-LIBRARY Version 2.4
    +#encoding utf-8
    +#
    +# Connector_Mini-DIN-6
    +#
    +DEF Connector_Mini-DIN-6 J 0 40 Y Y 1 F N
    +F0 "J" 0 250 50 H V C CNN
    +F1 "Connector_Mini-DIN-6" 0 -250 50 H V C CNN
    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
    [TestKeypad.kicad_pcb, TestKeypad.sch]
2020-05-10 Finalise test keypad r01 and silkscreen
    [TestKeypad.kicad_pcb]
2020-05-23 Don't bother writing extended fuse bits
2020-05-30 Tidy up matrix code and add sample keymap
2020-06-01 Fix the keypad issue
    I presume it's nothing to do with the extracted functions and more to do with manually resetting each pin before resampling.
    [main.cpp]
2020-06-01 Neaten up the keypad reading logic
    The whole keypad is scanned before sending anything to the host for completeness.
    It was the row reset that fixed the issue.
    [main.cpp]
2020-06-01 Reset keyboard matrix rows
    Avoids the complications had in 78cab8a
    [main.cpp]
2020-06-02 Move KP1 pin to PORTD5
2020-06-02 Add PWMed backlight controlled by * and # keys
2020-06-02 Remove CLK and DATA LEDs
    These are actually a part of the lines themselves now, so no need to waste cycles updating them anymore.
    Not that they were particularly reliable anyway.
2020-06-02 Toggle PWM when setting backlight to zero
    The backlight should be *all the way* off instead of just kinda off when it's set to off.
2020-06-03 Actually set the fuses properly
    Turns out avrdude's `-u` disables safemode and allows writing the fuses. A true case of RTFM right here.
2020-06-03 Fix issue where backlight will underflow and turn on
    It'd be handy if OCR2 were treated as an int by the inference of `increment`
    [main.cpp]
2020-06-04 Remove button definition
2020-06-06 Add timed interrupt to check for host comms
    It's much easier (and more reliable) to periodically break execution and check if the host wants to talk.
    This isn't a major problem when polling the matrix, but it is when we are transmitting, so interrupts are disabled when sending make/break codes.
    [main.cpp]
2020-06-06 Correctly reset PORTD when polling matrix
    [main.cpp]
2020-06-06 Sample CLK *and* DATA when checking for PS/2 RTS
    The CLK line is only held low for 100μs which is incredibly hard to catch. I tried solving this with an interrupt, but for some reason my system drops CLK a few times a second for no apparent reason, breaking execution far too frequently.
    After probing DATA for a bit, it seems that it gets held low significantly longer and is generally more reliable than checking CLK (this issue was also expressed in Harvie/ps2dev#8).
    [ps2dev.cpp]
2020-06-06 Store LED states explicitly
2020-06-06 Break backlight brightness functions down
    There's no need to take an arbitrary signed integer and try process that when we already rely on a definition to change the value.
    Due to an issue with the output compare module, only the output pin is disabled when disabling the backlight. This is because, if timed just right, the pin would remain toggled high when the timer is stopped and cannot (for whatever reason) be pulled low by the CPU. Disabling the output and leaving the timer running does not seem to have this problem.
    [main.cpp]
2020-06-07 Refactor handleKeypress with switches
    Making lots of exceptions in an if-else will look ugly later on
2020-06-07 Fix macro keys sending break codes
    [main.cpp]
2020-06-07 Fix more weird inversion cookery
    [main.cpp]
2020-06-07 Rework to match keyboard matrix schematic
    All debug and keypad logic has been removed to try ready this for testing in a production environment.
    [main.cpp, ps2dev.cpp]
2020-06-08 Fix status LEDs
    Seems the compiler dislikes inline ternary when combined with defines
    [main.cpp]
2020-07-24 Revise test keypad to r02
    Updated components to match the actual board and revised PCB layout
    [TestKeypad.kicad_pcb, TestKeypad.sch]
2020-08-01 Revise test keypad to r03
    Tweaked just before making a production run
    Added screw holes
    Added an ISP header
    Added pulldown resistor array to switch input lines
    Also remapped an incorrectly-placed "GND" label to the actual ground net (which slipped through into the production run)
    [TestKeypad.kicad_pcb, TestKeypad.sch]
2020-08-01 Update keyboard to match changes to keypad
    [MyOwnKeyboard.kicad_pcb, MyOwnKeyboard.sch]
2020-08-01 Change PS/2 socket and transistor references
    [MyOwnKeyboard.sch]
2020-08-01 Rename matrix driver pins
    Nets are case-insensitive, so the driver pins are now 1-6 instead of a-f
    [MyOwnKeyboard.sch]
2020-08-01 Update keyboard PCB template to match schematic
    [MyOwnKeyboard.kicad_pcb]
2020-08-01 Update diode and switch footprints
    [MyOwnKeyboard.kicad_pcb, MyOwnKeyboard.sch]
2020-08-03 Add custom cherry switch footprints
    Derived from those in the default libraries, but with the centre of the footprint actually in the centre of the footprint, not on pin 1.
2020-11-11 Add function key
    [MyOwnKeyboard.sch]
2020-11-11 Use pullup-sink method instead of pulldown
    Was having trouble with the pulldown resistors being finnicky.
    Instead of dealing with that, now we are reading the matrix from each column, using PORTD as a togglable sink (instead of being set high) for each row, and using ports A-C configured with pullups to measure if they have been pulled down on a keypress.
    This is considerably more reliable than the previous solution and requires minimal hardware change.
2020-11-12 Make matrix schematic compliant with pullup-sink method
    See 64d5791
    [MyOwnKeyboard.sch]
2020-11-12 Reverse diode orientation and reduce pad size
    [MyOwnKeyboard.kicad_pcb, MyOwnKeyboard.sch]
2020-11-12 Update keypad also
    [TestKeypad.kicad_pcb, TestKeypad.sch]
2020-11-12 Revise test keypad to r04
    Flipped numlock LED to the back of the board, using it as a diffuser
    Added design to blank area at the top
    Rounded off the corners
    [TestKeypad.kicad_pcb]
2020-11-21 Add component metadata incl. KiCost part details
    [MyOwnKeyboard.sch]
2020-12-05 Polish up template
    [MyOwnKeyboard.kicad_pcb]
2020-12-14 Add FnLock
    When pressed, FnLock will toggle Fn. The normal Fn key is inverted while FnLock is toggled on.
    [main.cpp]
2021-01-30 Add MX switch, Mini-DIN 6 socket, and LED 3D models
    [TestKeypad.kicad_pcb]
2021-11-30 Add key debouncing delay
    Based off of Timer1 which ticks at a rate of once per microsecond.
    All keys must now remain in the same state for at least KEY_BOUNCE_DELAY
    microseconds before they will be handled as a keypress.
